tpcannon7/ttsky-fir-tpcannon7/bringup/stm32/nucleo-f446re/Core/Src/main.c

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
/* Includes ------------------------------------------------------------------*/
#include "main.h"
#include <string.h>

/* USER CODE BEGIN PD */
#define FIR_STARTUP_LATENCY 2
#define UART_BLOCK_SIZE 256
#define SPI_BLOCK_SIZE 128
/* USER CODE END PD */

SPI_HandleTypeDef hspi2;
DMA_HandleTypeDef hdma_spi2_tx;
DMA_HandleTypeDef hdma_spi2_rx;

UART_HandleTypeDef huart2;
DMA_HandleTypeDef hdma_usart2_tx;
DMA_HandleTypeDef hdma_usart2_rx;

void SystemClock_Config(void);
static void MX_GPIO_Init(void);
static void MX_DMA_Init(void);
static void MX_SPI2_Init(void);
static void MX_USART2_UART_Init(void);
/* USER CODE BEGIN 0 */

typedef enum {
	FIR_COEFF_MODE,
	FIR_SAMPLE_MODE
}fir_state_t;

volatile fir_state_t fir_state = FIR_COEFF_MODE;

// 256 bytes = 128 samples
int8_t uart_tx_buf[UART_BLOCK_SIZE];
int8_t uart_rx_buf[UART_BLOCK_SIZE];

// 128 samples to FIR
int16_t spi_rx_buf[SPI_BLOCK_SIZE];
int16_t spi_tx_buf[SPI_BLOCK_SIZE];


void reset_fpga() {
  HAL_GPIO_WritePin(FIR_RST_N_GPIO_Port, FIR_RST_N_Pin, GPIO_PIN_RESET);
  HAL_Delay(1);
  HAL_GPIO_WritePin(FIR_RST_N_GPIO_Port, FIR_RST_N_Pin, GPIO_PIN_SET);
}

void load_coeffcients() {
	HAL_UART_Receive_DMA(&huart2, (uint8_t*)&uart_rx_buf, UART_BLOCK_SIZE);
}

void spi_transfer_coefficients() {
	HAL_GPIO_WritePin(FIR_MODE_GPIO_Port, FIR_MODE_Pin, GPIO_PIN_RESET);
	for (int i = 0; i < SPI_BLOCK_SIZE; i++) {
		HAL_GPIO_WritePin(CS_N_GPIO_Port, CS_N_Pin, GPIO_PIN_RESET);
		HAL_SPI_TransmitReceive(&hspi2, (uint8_t *)&spi_tx_buf[i], (uint8_t *)&spi_rx_buf[i], 1, HAL_MAX_DELAY);
		HAL_GPIO_WritePin(CS_N_GPIO_Port, CS_N_Pin, GPIO_PIN_SET);
	}
	HAL_GPIO_WritePin(FIR_MODE_GPIO_Port, FIR_MODE_Pin, GPIO_PIN_SET);
	fir_state = FIR_SAMPLE_MODE;
	memcpy(uart_tx_buf, spi_rx_buf, sizeof(uart_tx_buf));
	HAL_UART_Transmit_DMA(&huart2, (uint8_t *)&uart_tx_buf, UART_BLOCK_SIZE);

}

void spi_transfer_samples() {
	HAL_GPIO_WritePin(FIR_MODE_GPIO_Port, FIR_MODE_Pin, GPIO_PIN_SET);
	for (int i = 0; i < SPI_BLOCK_SIZE; i++) {
		HAL_GPIO_WritePin(CS_N_GPIO_Port, CS_N_Pin, GPIO_PIN_RESET);
		HAL_SPI_TransmitReceive(&hspi2, (uint8_t *)&spi_tx_buf[i], (uint8_t *)&spi_rx_buf[i], 1, HAL_MAX_DELAY);
		HAL_GPIO_WritePin(CS_N_GPIO_Port, CS_N_Pin, GPIO_PIN_SET);
	}
	memcpy(uart_tx_buf, spi_rx_buf, sizeof(uart_tx_buf));
	HAL_UART_Transmit_DMA(&huart2, (uint8_t *)&uart_tx_buf, UART_BLOCK_SIZE);
}


/* USER CODE END 0 */

/**
  * @brief  The application entry point.
  * @retval int
  */
int main(void)
{

  /* MCU Configuration--------------------------------------------------------*/

  /* Reset of all peripherals, Initializes the Flash interface and the Systick. */
  HAL_Init();

  /* Configure the system clock */
  SystemClock_Config();

  /* Initialize all configured peripherals */
  MX_GPIO_Init();
  MX_DMA_Init();
  MX_SPI2_Init();
  MX_USART2_UART_Init();
  /* USER CODE BEGIN 2 */

  reset_fpga();
  load_coeffcients();

  /* USER CODE END 2 */

  /* Infinite loop */
  /* USER CODE BEGIN WHILE */
  while (1)
  {
    /* USER CODE END WHILE */

    /* USER CODE BEGIN 3 */
  }
  /* USER CODE END 3 */
}

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
/* USER CODE BEGIN 4 */
void HAL_UART_RxCpltCallback(UART_HandleTypeDef *huart) {
    if (huart->Instance == USART2) {
    	memcpy(spi_tx_buf, uart_rx_buf, sizeof(spi_tx_buf));
    	if (fir_state == FIR_COEFF_MODE) {
    		spi_transfer_coefficients();
    	} else {
    		spi_transfer_samples();
    	}
    }
}

void HAL_UART_TxCpltCallback(UART_HandleTypeDef *huart) {
    if (huart->Instance == USART2) {
        HAL_UART_Receive_DMA(huart, (uint8_t *)&uart_rx_buf, UART_BLOCK_SIZE);
    }
}

/* USER CODE END 4 */
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
