tpcannon7/ttsky-fir-tpcannon7/bringup/stm32/nucleo-f446re/Core/Inc/main.h

#define B1_Pin GPIO_PIN_13
#define B1_GPIO_Port GPIOC
#define USART_TX_Pin GPIO_PIN_2
#define USART_TX_GPIO_Port GPIOA
#define USART_RX_Pin GPIO_PIN_3
#define USART_RX_GPIO_Port GPIOA
#define LD2_Pin GPIO_PIN_5
#define LD2_GPIO_Port GPIOA
#define FIR_RST_N_Pin GPIO_PIN_1
#define FIR_RST_N_GPIO_Port GPIOB
#define CS_N_Pin GPIO_PIN_2
#define CS_N_GPIO_Port GPIOB
#define FIR_MODE_Pin GPIO_PIN_12
#define FIR_MODE_GPIO_Port GPIOB
#define TMS_Pin GPIO_PIN_13
#define TMS_GPIO_Port GPIOA
#define TCK_Pin GPIO_PIN_14
#define TCK_GPIO_Port GPIOA
#define SWO_Pin GPIO_PIN_3
#define SWO_GPIO_Port GPIOB
