tpcannon7/ttsky-fir-tpcannon7/src/spi.v

`default_nettype none

module spi (
    input wire clk,
    input wire rst_n,

    // spi signals
    input  wire sclk,
    input  wire mosi,
    input  wire cs_n,
    output wire miso,

    input wire fir_mode,

    // internal transfer
    input wire [11:0] tx_data_in,
    output wire [11:0] rx_data_out,
    output wire spi_rx_valid,
    output wire curr_frame_fir_mode
);

  localparam SpiFrameWidth = 16;

  wire sclk_rising, cs_n_rising, sclk_falling, cs_n_falling;

  assign sclk_rising  = (sclk_sync[1] == 1'b1) && (sclk_sync[2] == 1'b0);
  assign sclk_falling = (sclk_sync[1] == 1'b0) && (sclk_sync[2] == 1'b1);

  assign cs_n_rising  = (cs_n_sync[1] == 1'b1) && (cs_n_sync[2] == 1'b0);
  assign cs_n_falling = (cs_n_sync[1] == 1'b0) && (cs_n_sync[2] == 1'b1);

  // new "fir_mode" pin will function as: LOW == coeff frame, HIGH == sample frame
  // we will idle the fir_mode pin at high (default samples), coeff loading is pulling low as
  // a special case

  reg [2:0] sclk_sync, cs_n_sync, fir_mode_sync;
  reg [2:0] mosi_sync;

  reg [SpiFrameWidth-1:0] rx_buf, tx_buf;
  // bit count needs to hold 1-16 since we increment on first sclk cycle from
  // 0-1 and miss the final bit if we count to 15 (only 14 bits with counter 1-15)
  reg [$clog2(SpiFrameWidth):0] bit_cnt;
  reg curr_frame_fir_mode_reg;

  reg [SpiFrameWidth-1:0] tx_safe_buf;
  reg tx_fetch_ready;

  always @(posedge clk or negedge rst_n) begin : reg_sync_flops
    if (~rst_n) begin
      sclk_sync <= 3'b000;
      mosi_sync <= 3'b000;
      cs_n_sync <= 3'b111;
      fir_mode_sync <= 3'b111;
    end else begin
      sclk_sync[0] <= sclk;
      sclk_sync[1] <= sclk_sync[0];
      sclk_sync[2] <= sclk_sync[1];

      mosi_sync[0] <= mosi;
      mosi_sync[1] <= mosi_sync[0];
      mosi_sync[2] <= mosi_sync[1];

      cs_n_sync[0] <= cs_n;
      cs_n_sync[1] <= cs_n_sync[0];
      cs_n_sync[2] <= cs_n_sync[1];

      fir_mode_sync[0] <= fir_mode;
      fir_mode_sync[1] <= fir_mode_sync[0];
      fir_mode_sync[2] <= fir_mode_sync[1];
    end
  end

  localparam [1:0] Idle = 2'b00, Busy = 2'b01, Done = 2'b10;
  reg [1:0] curr_st, next_st;

  assign spi_rx_valid = (curr_st == Done);
  // curr_frame_fir_mode latched mid spi frame; only sampled when spi_rx_valid is high
  assign curr_frame_fir_mode = curr_frame_fir_mode_reg;

  always @(posedge clk or negedge rst_n) begin : reg_curr_st
    if (~rst_n) begin
      curr_st <= Idle;
    end else begin
      curr_st <= next_st;
    end
  end

  always @(*) begin : comb_next_st
    next_st = curr_st;
    case (curr_st)
      Idle: begin
        if (cs_n_falling) begin
          next_st = Busy;
        end
      end
      Busy: begin
        if (bit_cnt == (SpiFrameWidth)) begin
          next_st = Done;
        end else if (cs_n_rising) begin
          next_st = Idle;  // erroneous cs_n HIGH during transaction
        end
      end
      Done: begin
        next_st = Idle;
      end
      default: next_st = curr_st;
    endcase
  end

  assign miso = (curr_st == Busy) ? tx_buf[SpiFrameWidth-1] : 1'b0;
  assign rx_data_out = rx_buf[15:4];

  always @(posedge clk or negedge rst_n) begin : reg_spi_mosi_shift
    if (~rst_n) begin
      rx_buf <= 0;
    end else if (curr_st == Busy && sclk_rising) begin
      rx_buf <= {rx_buf[SpiFrameWidth-2:0], mosi_sync[2]};
    end else if (curr_st == Idle) begin
      rx_buf <= 0;
    end
  end

  always @(posedge clk or negedge rst_n) begin : reg_spi_bit_cnt
    if (~rst_n) begin
      bit_cnt <= 0;
    end else if (curr_st == Busy && sclk_rising) begin
      bit_cnt <= bit_cnt + 1'b1;
    end else if (bit_cnt == (SpiFrameWidth)) begin
      bit_cnt <= 0;
    end else if (curr_st == Idle) begin
      bit_cnt <= 0;
    end
  end

  // we save a copy of the incoming tx/fir output
  // we keep this copy so that in case we fail a spi transaction
  // the tx/miso buffer doesn't get overwritten
  // gives better protection if cs_n is pulled high mid spi transfer
  always @(posedge clk or negedge rst_n) begin : reg_tx_safe_buf
    if (~rst_n) begin
      tx_fetch_ready <= 1'b1;
      tx_safe_buf <= 0;
    end else if (cs_n_falling && tx_fetch_ready == 1'b1) begin
      tx_fetch_ready <= 1'b0;
      tx_safe_buf <= {tx_data_in, 4'b0000};
    end else if (curr_st == Done) begin
      tx_fetch_ready <= 1'b1;
    end
  end

  always @(posedge clk or negedge rst_n) begin : reg_miso_shift
    if (~rst_n) begin
      tx_buf <= 0;
    end else if (curr_st == Busy && sclk_falling) begin
      tx_buf <= {tx_buf[SpiFrameWidth-2:0], 1'b0};
    end else if (cs_n_falling) begin
      tx_buf <= tx_fetch_ready == 1'b1 ? {tx_data_in, 4'b0000} : tx_safe_buf;
    end
  end

  always @(posedge clk or negedge rst_n) begin : reg_fir_mode
    if (~rst_n) begin
      curr_frame_fir_mode_reg <= 0;
    end else if (bit_cnt == (SpiFrameWidth / 2)) begin  // capture fir_mode in middle of frame
      curr_frame_fir_mode_reg <= fir_mode_sync[2];
    end else if (curr_st == Idle) begin
      curr_frame_fir_mode_reg <= 0;
    end
  end

endmodule

`default_nettype wire
