tpcannon7/ttsky-fir-tpcannon7/(commit log)

2026-06-09 fix reg synth error
    [fir_filter.v, tt_um_tpcannon7_fir.v]
2026-06-10 sample driver issue
2026-06-10 fix mac idx logic
    [fir_filter.v]
2026-06-26 16 bit coeffs/samples!
2026-06-26 verilator unused signal fix
    [tt_um_tpcannon7_fir.v]
2026-06-30 lets try 25mhz + some cocotb changes for GL fix?
    [fir_filter.v, fir_tb.py]
2026-07-01 trunc mult docs + possible GL sim fix
    [fir_filter.v, fir_tb.py, trunc_mult.v]
2026-07-02 loop index integer driver issue
    [fir_filter.v]
2026-07-06 wip test module, need to fix possible issues with async pins/cdc synchronization
    [fir_filter.v, fir_tb.py, tt_um_tpcannon7_fir.v]
2026-07-07 spi instead of prev interface
2026-07-08 spi slave start
2026-07-10 spi slave new framing method + control layer start, try testbench fixes
    [control.v, fir_filter.v, fir_tb.py, spi_slave.v, tt_um_tpcannon7_fir.v]
2026-07-11 testbench progress, datapath works need to fix control/spi framing
    [control.v, fir_filter.v, fir_tb.py, spi_slave.v, tb.v, tt_um_tpcannon7_fir.v]
2026-07-13 full working flow (spi,control, FIR); need to fix initial garbage/0 spi frames
    [control.v, fir_tb.py, spi_slave.v, tt_um_tpcannon7_fir.v]
2026-07-13 spi module complete + tests now working
2026-07-13 12 bit samples + coeffs, lets try 1x2
2026-07-14 wip new tests add; double check spi interface logic on clearing cs_n high during transaction
2026-07-16 updated docs; fixed overflow issue in step response/fir logic
    [fir_filter.v, fir_tb.py, trunc_mult.v]
2026-07-19 docs polish/spelling, fixed mode misname in fir_filter.v[skip ci]
    [fir_filter.v, fir_tb.py, spi.v, tt_um_tpcannon7_fir.v]
2026-07-19 fixed miso tristate/miso negedge sensitivity; expanded docs, seeded testbench with default random; MODE -> FIR_MODE naming
    [control.v, fir_tb.py, spi.v, tb.v, trunc_mult.v, tt_um_tpcannon7_fir.v]
2026-07-19 added small mac pipeline to fix timing
    [fir_filter.v, fir_tb.py]
2026-07-20 docs cleanup for new spec, regen plots [skip ci]
    [fir_filter.v, fir_tb.py]
2026-07-22 added trunc mult stats + plot + test suite, fixed trunc_mult.v linter warnings
    [baseline_mult.v, fir_tb.py, plot_trunc_statistics.py, tb_trunc_mult.v, trunc_mult.v, trunc_mult_tb.py]
2026-07-22 fix plot size for trunc mult [skip ci]
    [plot_trunc_statistics.py]
2026-07-22 small test refactor, cleaned docs, fixed default_nettype
    [control.v, fir_filter.v, fir_tb.py, plot_trunc_statistics.py, spi.v, trunc_mult.v, trunc_mult_tb.py, tt_um_tpcannon7_fir.v]
2026-07-27 bringup/validation on fpga + stm32
2026-07-27 add stm32 build files to .gitattributes [skip ci]
2026-07-28 repo cleanup, docs fixes
    [baseline_mult.v, control.v, fir_filter.v, fir_tb.py, fpga_top.v, gowin_pll.v, gowin_pll_mod.v]
2026-07-28 spi section wording, small section to multiplier tradeoff in info.md [skip ci]
2026-08-01 remove .gitattributes line ending rules, fix stm32_serial_interface.py variable name mismatch [skip ci]
    [stm32_serial_interface.py]
2026-09-07 init cadence flow
2026-09-07 working innovus flow
2026-09-07 final cadence flow docs and results [skip ci]
