tpcannon7/ttsky-fir-tpcannon7/(notices)

Notices in the files:
bringup/stm32/nucleo-f446re/Core/Src/main.c:
Copyright (c) 2026 STMicroelectronics.
All rights reserved.
This software is licensed under terms that can be found in the LICENSE file
